MikePythons/Charjsmol/chargesmol_c.png

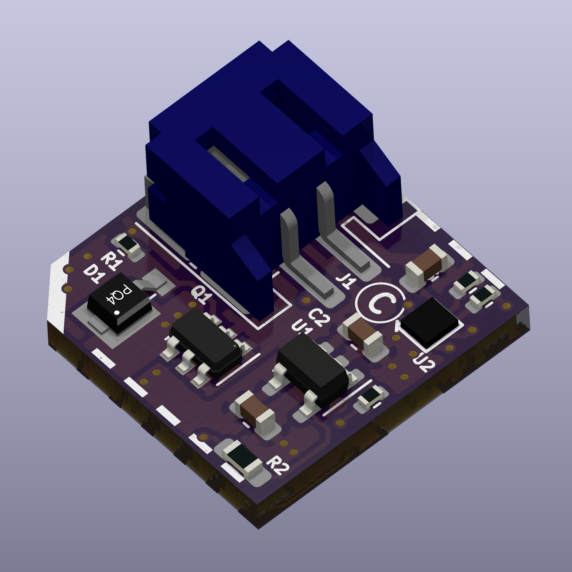
chargesmol_c.png
