MikePythons/Charjsmol/Charj_Smol.kicad_pcb

## KiCad design Charj_Smol.kicad_pcb (2021-12-24)

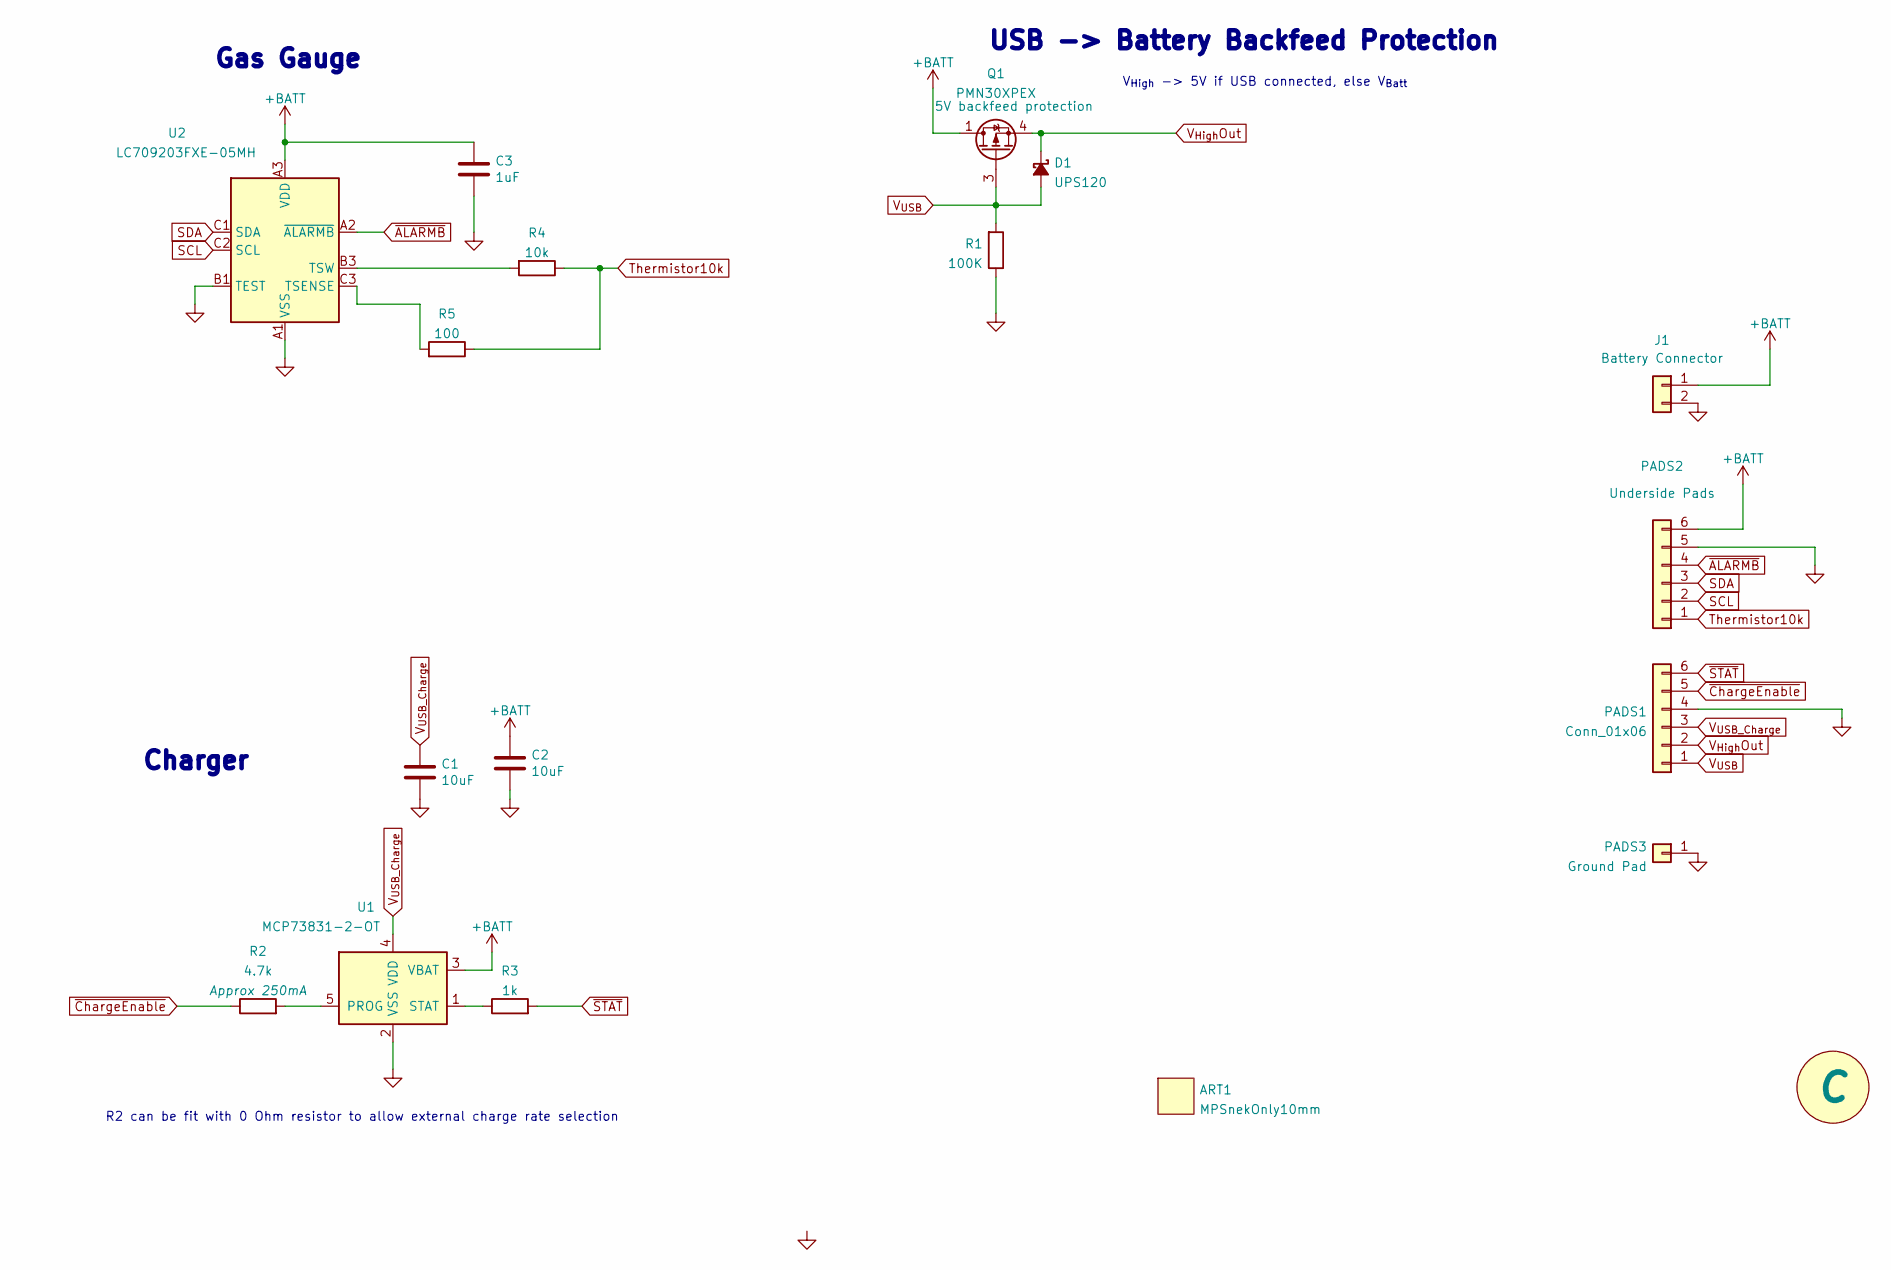
[picture p2: schematic Charj_Smol.kicad_sch]

Parts:
ART1: MPSnekOnly10mm; MPSnekOnly_10x6mm
C1, C2: 10uF; C_0603_1608Metric
C3: 1uF; C_0603_1608Metric
D1: UPS120; UPS120_D_Powermite_AK
J1: Battery Connector; JST_PH_S2B_B2B_Vers
MISC1: C; RevisionSymbol_Small
PADS1: Conn_01x06; EdgePad_1x06
PADS2: Underside Pads; EdgePad_1x06
PADS3: Ground Pad; GND_PAD
Q1: PMN30XPEX; TSOP-6_1.65x3.05mm_P0.95mm
R1: 100K; R_0402_1005Metric
R2: 4.7k; R_0603_1608Metric_Pad0.98x0.95mm_HandSolder
R3: 1k; R_0402_1005Metric
R4: 10k; R_0402_1005Metric
R5: 100; R_0402_1005Metric
U1: MCP73831-2-OT; SOT-23-5
U2: LC709203FXE-05MH; WLCSP9-1.60x1.76mm

Connections:
+BATT: C2.1, C3.1, J1.1, PADS2.6, Q1.1 (D), Q1.2 (D), Q1.5 (D), Q1.6 (D), U1.3 (VBAT), U2.A3 (VDD)
GND: C1.2, C2.2, C3.2, J1.2, PADS1.4, PADS2.5, PADS3.1, R1.1, U1.2 (VSS), U2.A1 (VSS), U2.B1 (TEST)
unnamed: R2.2, U1.5 (PROG)
unnamed: R3.1, U1.1 (STAT)
unnamed: R4.2, U2.B3 (TSW)
unnamed: R5.2, U2.C3 (TSENSE)
SCL: PADS2.2, U2.C2 (SCL)
SDA: PADS2.3, U2.C1 (SDA)
Thermistor10k: PADS2.1, R4.1, R5.1
V_{High}Out: D1.1 (K), PADS1.2, Q1.4 (S)
V_{USB_Charge}: C1.1, PADS1.3, U1.4 (VDD)
V_{USB}: D1.2 (A), PADS1.1, Q1.3 (G), R1.2
~ALARMB: PADS2.4, U2.A2 (~ALARMB)
~ChargeEnable: PADS1.5, R2.1
~STAT: PADS1.6, R3.2

Notes on the sheet:
R2 can be fit with 0 Ohm resistor to allow external charge rate selection
USB -> Battery Backfeed Protection
Gas Gauge
V_{High} -> 5V if USB connected, else V_{Batt}
Charger

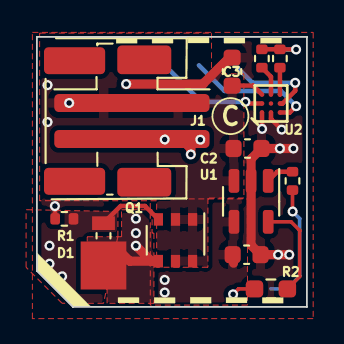
[picture p3: board Charj_Smol.kicad_pcb from above]

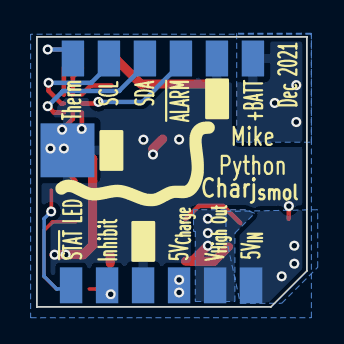
[picture p4: board Charj_Smol.kicad_pcb from below]

Board: 2 copper layers, 15.0 x 15.0 mm, 18 parts (4 on the bottom side), 15 nets.
