MikePythons/Charjsmol/(commit log)

2021-12-24 Revision C
    - Fixed battery connector polarity
    - Added silkscreen marks to help align bottom pads with footprint when placing on carrier board
    [Charj_Smol.kicad_pcb, Charj_Smol.kicad_sch]
2021-12-24 Silkscreen tidying; still Rev C
    [Charj_Smol.kicad_pcb, Charj_Smol.kicad_sch]
2021-12-24 Forgot to save board before previous commit. Moving RevC marker to this commit.
    [Charj_Smol.kicad_pcb]
